EtchedPixels/Z180MiniITX/README.md

# Z180 Mini-ITX Mother Board

This very much an initial work in progress.
