EtchedPixels/Z180MiniITX/Z180Mboard-v3.kicad_pcb

## KiCad design Z180Mboard-v3.kicad_pcb (2022-03-06)

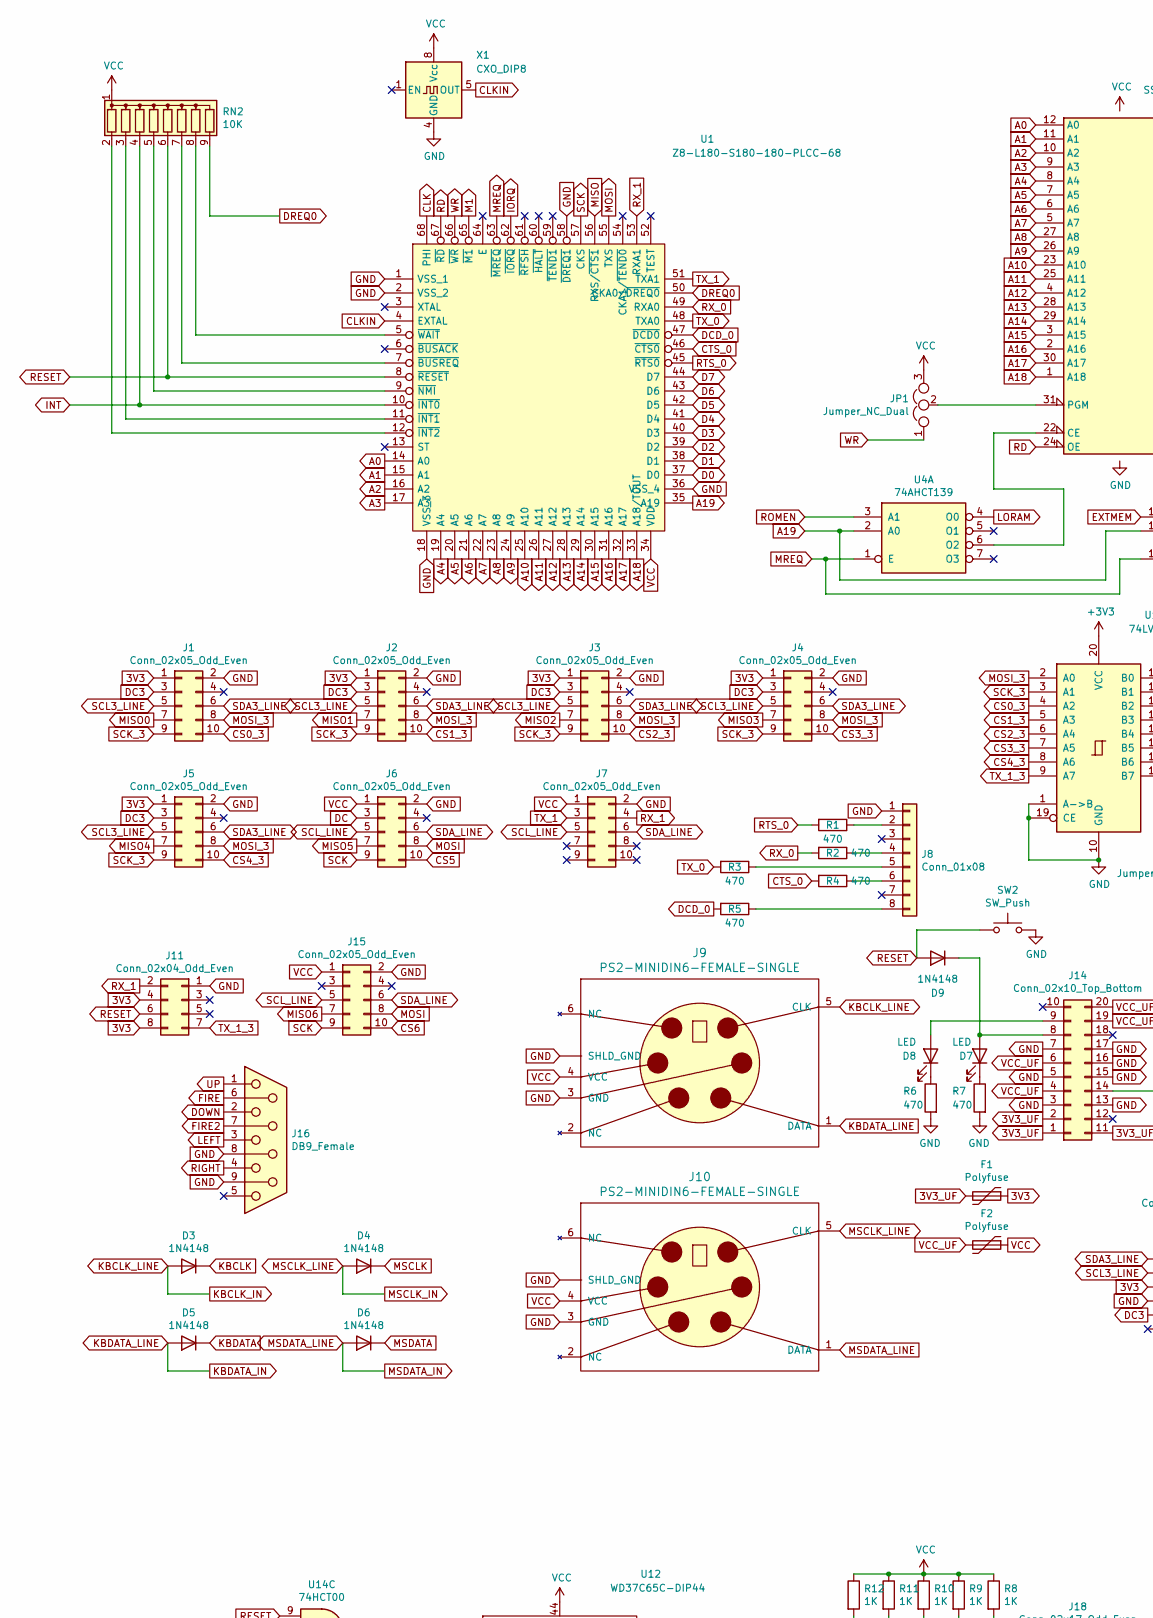
[picture p1: schematic Z180Mboard-v3.sch, part in row 1, column 1]

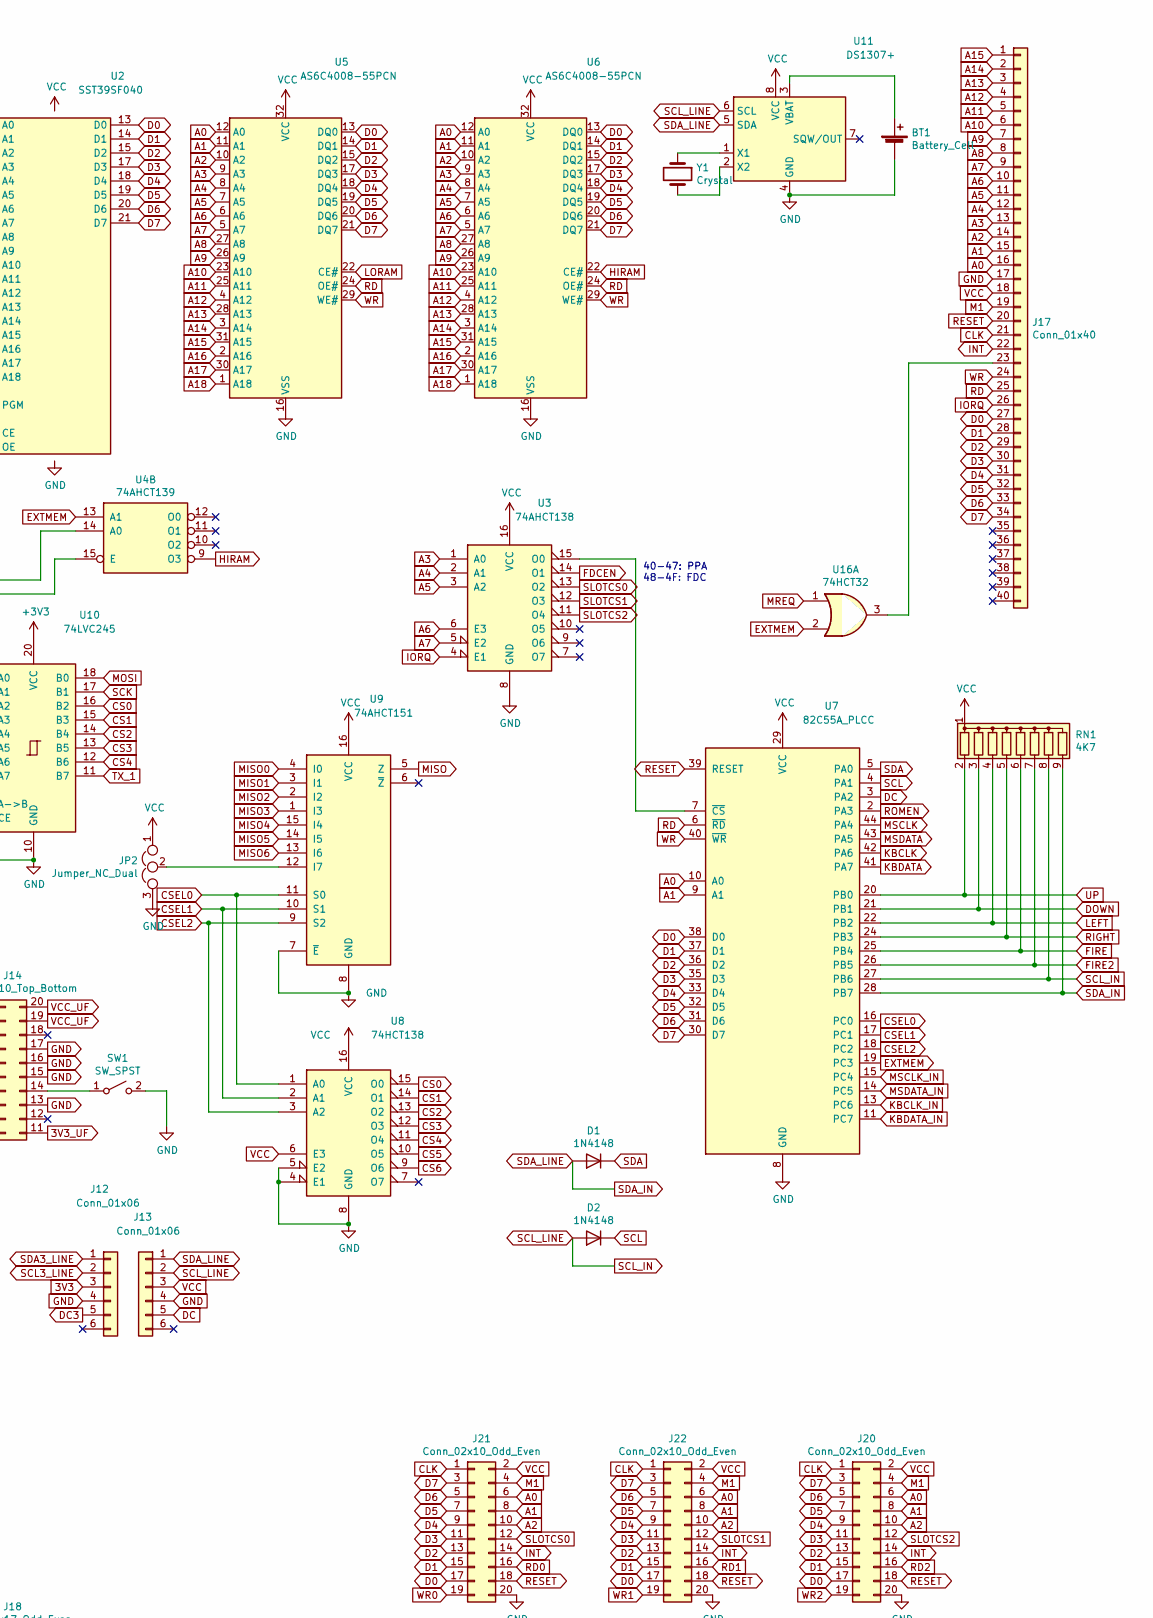
[picture p2: schematic Z180Mboard-v3.sch, part in row 1, column 2]

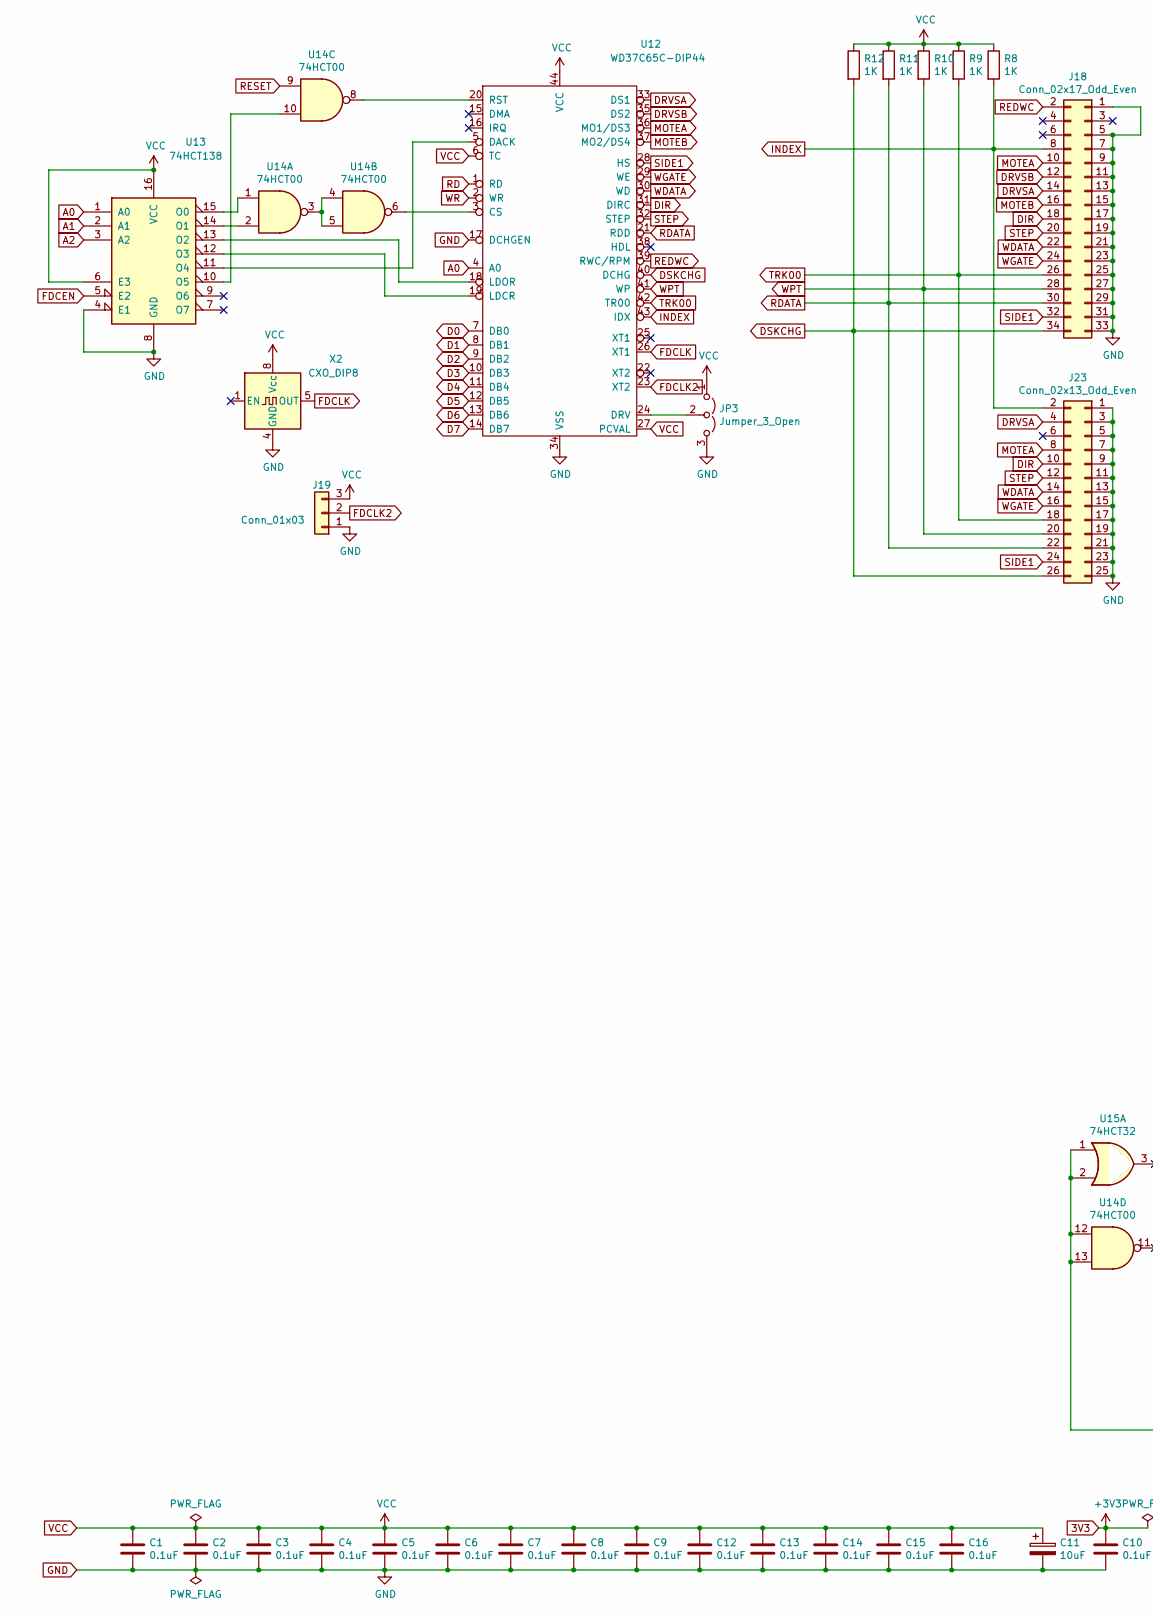
[picture p3: schematic Z180Mboard-v3.sch, part in row 2, column 1]

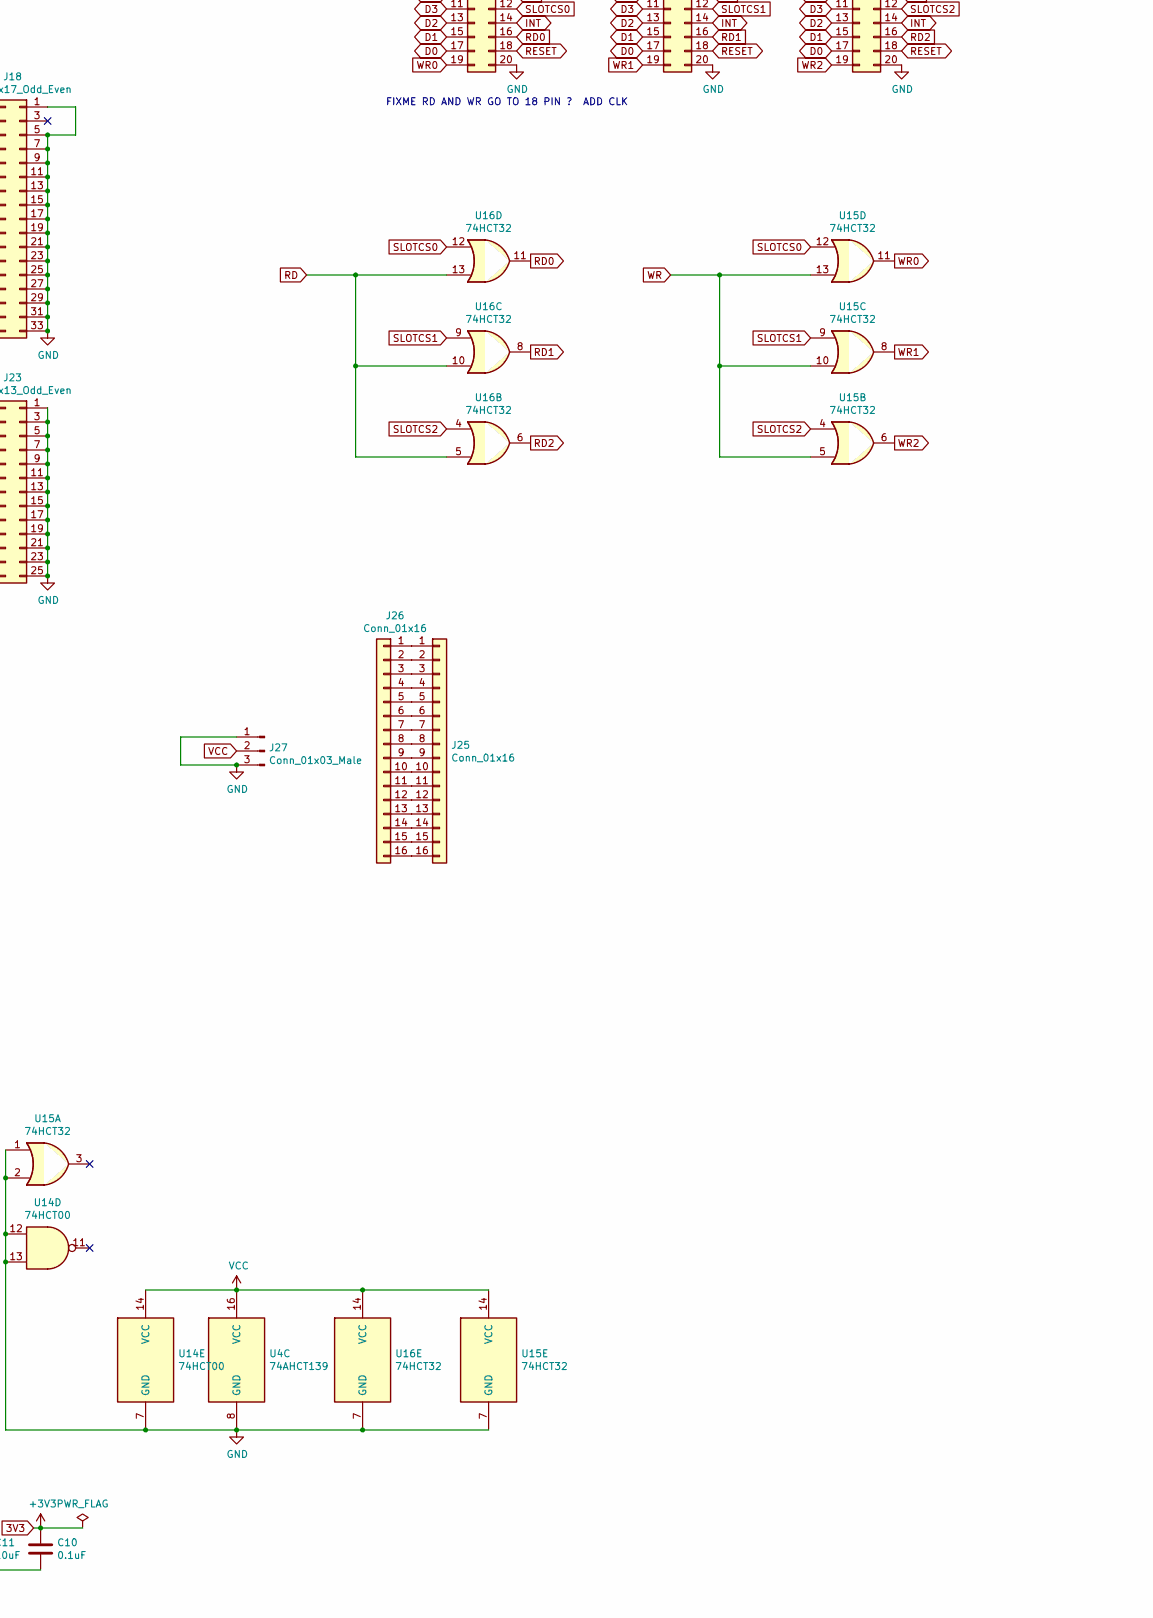
[picture p4: schematic Z180Mboard-v3.sch, part in row 2, column 2]

Parts:
BT1: Battery_Cell; BatteryHolder_Keystone_1060_1x2032
C1, C2, C3, C4, C5, C6, C7, C8, C9, C10, C12, C13, C14, C15, C16: 0.1uF; C_Disc_D3.0mm_W2.0mm_P2.50mm
C11: 10uF; CP_Radial_D10.0mm_P3.50mm
D1, D2, D3, D4, D5, D6, D9: 1N4148; D_DO-35_SOD27_P7.62mm_Horizontal
D7, D8: LED; PinHeader_1x02_P2.54mm_Vertical
F1, F2: Polyfuse; Fuse_Littelfuse-LVR100
J1, J2, J3, J4, J5, J6, J7, J15: Conn_02x05_Odd_Even; IDC-Header_2x05_P2.54mm_Vertical
J8: Conn_01x08; PinSocket_1x08_P2.54mm_Horizontal
J9, J10: PS2-MINIDIN6-FEMALE-SINGLE; MINI-DIN-6-FULL-SHIELD
J11: Conn_02x04_Odd_Even; PinSocket_2x04_P2.54mm_Vertical
J12, J13: Conn_01x06; PinHeader_1x06_P2.54mm_Vertical
J14: Conn_02x10_Top_Bottom; Molex_Mini-Fit_Jr_5566-20A_2x10_P4.20mm_Vertical
J16: DB9_Female; DSUB-9_Female_Horizontal_P2.77x2.54mm_EdgePinOffset9.40mm
J17: Conn_01x40; PinSocket_1x40_P2.54mm_Vertical
J18: Conn_02x17_Odd_Even; IDC-Header_2x17_P2.54mm_Vertical
J19: Conn_01x03; PinHeader_1x03_P2.54mm_Vertical
J20, J21, J22: Conn_02x10_Odd_Even; PinSocket_2x10_P2.54mm_Vertical
J23: Conn_02x13_Odd_Even; IDC-Header_2x13_P2.54mm_Vertical
J25: Conn_01x16; PinHeader_1x16_P2.54mm_Horizontal
J26: Conn_01x16; PinHeader_1x16_P2.54mm_Vertical
J27: Conn_01x03_Male; PinHeader_1x03_P2.54mm_Vertical
JP1, JP2: Jumper_NC_Dual; PinHeader_1x03_P2.54mm_Vertical
JP3: Jumper_3_Open; PinHeader_1x03_P2.54mm_Vertical
R1, R2, R3, R4, R5, R6, R7: 470; R_Axial_DIN0207_L6.3mm_D2.5mm_P7.62mm_Horizontal
R8, R9, R10, R11, R12: 1K; R_Axial_DIN0207_L6.3mm_D2.5mm_P7.62mm_Horizontal
RN1: 4K7; R_Array_SIP9
RN2: 10K; R_Array_SIP9
SW1: SW_SPST; PinHeader_1x02_P2.54mm_Vertical
SW2: SW_Push; PinHeader_1x02_P2.54mm_Vertical
U1: Z8-L180-S180-180-PLCC-68; PLCC-68_THT-Socket; Manufacturer_Part_Number Z8S18033VSG; Mouser Part Number 692-Z8S18033VSG
U2: SST39SF040; DIP-32_W15.24mm_Socket
U3: 74AHCT138; DIP-16_W7.62mm_Socket
U4: 74AHCT139; DIP-16_W7.62mm_Socket
U5, U6: AS6C4008-55PCN; DIP-32_W15.24mm
U7: 82C55A_PLCC; PLCC-44_THT-Socket
U8, U13: 74HCT138; DIP-16_W7.62mm_Socket
U9: 74AHCT151; DIP-16_W7.62mm_Socket
U10: 74LVC245; DIP-20_W7.62mm_Socket
U11: DS1307+; DIP-8_W7.62mm
U12: WD37C65C-DIP44; PLCC-44_THT-Socket
U14: 74HCT00; DIP-14_W7.62mm_Socket
U15, U16: 74HCT32; DIP-14_W7.62mm_Socket
X1, X2: CXO_DIP8; Oscillator_DIP-8
Y1: Crystal; Crystal_C26-LF_D2.1mm_L6.5mm_Vertical

Connections:
3V3: C10.1, F1.1, J1.1, J2.1, J3.1, J4.1, J5.1, J11.4, J11.8, J12.3, U10.20 (VCC)
3V3_UF: F1.2, J14.1, J14.2, J14.11
A0: J17.16, J20.6, J21.6, J22.6, U1.14 (A0), U2.12 (A0), U5.12 (A0), U6.12 (A0), U7.10 (A0), U12.4 (A0), U13.1 (A0)
A1: J17.15, J20.8, J21.8, J22.8, U1.15 (A1), U2.11 (A1), U5.11 (A1), U6.11 (A1), U7.9 (A1), U13.2 (A1)
A2: J17.14, J20.10, J21.10, J22.10, U1.16 (A2), U2.10 (A2), U5.10 (A2), U6.10 (A2), U13.3 (A2)
A3: J17.13, U1.17 (A3), U2.9 (A3), U3.1 (A0), U5.9 (A3), U6.9 (A3)
A4: J17.12, U1.19 (A4), U2.8 (A4), U3.2 (A1), U5.8 (A4), U6.8 (A4)
A5: J17.11, U1.20 (A5), U2.7 (A5), U3.3 (A2), U5.7 (A5), U6.7 (A5)
A6: J17.10, U1.21 (A6), U2.6 (A6), U3.6 (E3), U5.6 (A6), U6.6 (A6)
A7: J17.9, U1.22 (A7), U2.5 (A7), U3.5 (E2), U5.5 (A7), U6.5 (A7)
A8: J17.8, U1.23 (A8), U2.27 (A8), U5.27 (A8), U6.27 (A8)
A9: J17.7, U1.24 (A9), U2.26 (A9), U5.26 (A9), U6.26 (A9)
A10: J17.6, U1.25 (A10), U2.23 (A10), U5.23 (A10), U6.23 (A10)
A11: J17.5, U1.26 (A11), U2.25 (A11), U5.25 (A11), U6.25 (A11)
A12: J17.4, U1.27 (A12), U2.4 (A12), U5.4 (A12), U6.4 (A12)
A13: J17.3, U1.28 (A13), U2.28 (A13), U5.28 (A13), U6.28 (A13)
A14: J17.2, U1.29 (A14), U2.29 (A14), U5.3 (A14), U6.3 (A14)
A15: J17.1, U1.30 (A15), U2.3 (A15), U5.31 (A15), U6.31 (A15)
A16: U1.31 (A16), U2.2 (A16), U5.2 (A16), U6.2 (A16)
A17: U1.32 (A17), U2.30 (A17), U5.30 (A17), U6.30 (A17)
A18: U1.33 (A18/TOUT), U2.1 (A18), U5.1 (A18), U6.1 (A18)
A19: U1.35 (A19), U4.2 (A0), U4.14 (A0)
CLK: J17.21, J20.1, J21.1, J22.1, U1.68 (PHI)
CLKIN: U1.4 (EXTAL), X1.5 (OUT)
CS0: U8.15 (O0), U10.16 (B2)
CS0_3: J1.10, U10.4 (A2)
CS1: U8.14 (O1), U10.15 (B3)
CS1_3: J2.10, U10.5 (A3)
CS2: U8.13 (O2), U10.14 (B4)
CS2_3: J3.10, U10.6 (A4)
CS3: U8.12 (O3), U10.13 (B5)
CS3_3: J4.10, U10.7 (A5)
CS4: U8.11 (O4), U10.12 (B6)
CS4_3: J5.10, U10.8 (A6)
CS5: J6.10, U8.10 (O5)
CS6: J15.10, U8.9 (O6)
CSEL0: U7.16 (PC0), U8.1 (A0), U9.11 (S0)
CSEL1: U7.17 (PC1), U8.2 (A1), U9.10 (S1)
CSEL2: U7.18 (PC2), U8.3 (A2), U9.9 (S2)
CTS_0: R4.2, U1.46 (~CTS0)
D0: J17.27, J20.17, J21.17, J22.17, U1.37 (D0), U2.13 (D0), U5.13 (DQ0), U6.13 (DQ0), U7.38 (D0), U12.7 (DB0)
D1: J17.28, J20.15, J21.15, J22.15, U1.38 (D1), U2.14 (D1), U5.14 (DQ1), U6.14 (DQ1), U7.37 (D1), U12.8 (DB1)
D2: J17.29, J20.13, J21.13, J22.13, U1.39 (D2), U2.15 (D2), U5.15 (DQ2), U6.15 (DQ2), U7.36 (D2), U12.9 (DB2)
D3: J17.30, J20.11, J21.11, J22.11, U1.40 (D3), U2.17 (D3), U5.17 (DQ3), U6.17 (DQ3), U7.35 (D3), U12.10 (DB3)
D4: J17.31, J20.9, J21.9, J22.9, U1.41 (D4), U2.18 (D4), U5.18 (DQ4), U6.18 (DQ4), U7.33 (D4), U12.11 (DB4)
D5: J17.32, J20.7, J21.7, J22.7, U1.42 (D5), U2.19 (D5), U5.19 (DQ5), U6.19 (DQ5), U7.32 (D5), U12.12 (DB5)
D6: J17.33, J20.5, J21.5, J22.5, U1.43 (D6), U2.20 (D6), U5.20 (DQ6), U6.20 (DQ6), U7.31 (D6), U12.13 (DB6)
D7: J17.34, J20.3, J21.3, J22.3, U1.44 (D7), U2.21 (D7), U5.21 (DQ7), U6.21 (DQ7), U7.30 (D7), U12.14 (DB7)
DC: J6.3, J13.5, U7.3 (PA2)
DC3: J1.3, J2.3, J3.3, J4.3, J5.3, J12.5
DCD_0: R5.2, U1.47 (~DCD0)
DIR: J18.18, J23.10, U12.31 (DIRC)
DOWN: J16.2, RN1.3 (R2), U7.21 (PB1)
DREQ0: RN2.9 (R8), U1.50 (CKA0/~DREQ0)
DRVSA: J18.14, J23.4, U12.33 (DS1)
DRVSB: J18.12, U12.35 (DS2)
DSKCHG: J18.34, J23.26, R12.2, U12.40 (DCHG)
EXTMEM: U4.13 (A1), U7.19 (PC3), U16.2
FDCEN: U3.14 (O1), U13.5 (E2)
FDCLK: U12.26 (XT1), X2.5 (OUT)
FDCLK2: J19.2, U12.23 (XT2)
FIRE: J16.6, RN1.6 (R5), U7.25 (PB4)
FIRE2: J16.7, RN1.7 (R6), U7.26 (PB5)
GND: BT1.2 (-), C1.2, C2.2, C3.2, C4.2, C5.2, C6.2, C7.2, C8.2, C9.2, C10.2, C11.2, C12.2, C13.2, C14.2, C15.2, C16.2, J1.2, J2.2, J3.2, J4.2, J5.2, J6.2, J7.2, J8.1, J9.3 (GND), J9.~ (SHLD_GND), J10.3 (GND), J10.~ (SHLD_GND), J11.1, J12.4, J13.4, J14.3, J14.5, J14.7, J14.13, J14.15, J14.16, J14.17, J15.2, J16.8, J16.9, J17.17, J18.1, J18.5, J18.7, J18.9, J18.11, J18.13, J18.15, J18.17, J18.19, J18.21, J18.23, J18.25, J18.27, J18.29, J18.31, J18.33, J19.1, J20.20, J21.20, J22.20, J23.1, J23.3, J23.5, J23.7, J23.9, J23.11, J23.13, J23.15, J23.17, J23.19, J23.21, J23.23, J23.25, J27.1, J27.3, JP2.3, JP3.3 (B), R6.2, R7.2, SW1.2 (B), SW2.2, U1.1 (VSS_1), U1.2 (VSS_2), U1.18 (VSS_3), U1.36 (VSS_4), U1.58 (~DREQ1), U2.16 (GND), U3.8 (GND), U4.8 (GND), U5.16 (VSS), U6.16 (VSS), U7.8 (GND), U8.4 (E1), U8.5 (E2), U8.8 (GND), U9.7 (~E), U9.8 (GND), U10.1 (A->B), U10.10 (GND), U10.19 (CE), U11.4 (GND), U12.17 (DCHGEN), U12.34 (VSS), U13.4 (E1), U13.8 (GND), U14.7 (GND), U14.12, U14.13, U15.1, U15.2, U15.7 (GND), U16.7 (GND), X1.4 (GND), X2.4 (GND)
HIRAM: U4.9 (O3), U6.22 (CE#)
INDEX: J18.8, J23.2, R8.2, U12.43 (IDX)
INT: J17.22, J20.14, J21.14, J22.14, RN2.4 (R3), U1.10 (~INT0)
IORQ: J17.26, U1.62 (~IORQ), U3.4 (E1)
KBCLK: D3.1 (K), U7.42 (PA6)
KBCLK_IN: D3.2 (A), J9.5 (CLK), U7.13 (PC6)
KBDATA: D5.1 (K), U7.41 (PA7)
KBDATA_IN: D5.2 (A), J9.1 (DATA), U7.11 (PC7)
LEFT: J16.3, RN1.4 (R3), U7.22 (PB2)
LORAM: U4.4 (O0), U5.22 (CE#)
M1: J17.19, J20.4, J21.4, J22.4, U1.65 (~M1)
MISO: U1.56 (RXS/~CTS1), U9.5 (Z)
MISO0: J1.7, U9.4 (I0)
MISO1: J2.7, U9.3 (I1)
MISO2: J3.7, U9.2 (I2)
MISO3: J4.7, U9.1 (I3)
MISO4: J5.7, U9.15 (I4)
MISO5: J6.7, U9.14 (I5)
MISO6: J15.7, U9.13 (I6)
MOSI: J6.8, J15.8, U1.55 (TXS), U10.18 (B0)
MOSI_3: J1.8, J2.8, J3.8, J4.8, J5.8, U10.2 (A0)
MOTEA: J18.10, J23.8, U12.36 (MO1/DS3)
MOTEB: J18.16, U12.37 (MO2/DS4)
MREQ: U1.63 (~MREQ), U4.1 (E), U4.15 (E), U16.1
MSCLK: D4.1 (K), U7.44 (PA4)
MSCLK_IN: D4.2 (A), J10.5 (CLK), U7.15 (PC4)
MSDATA: D6.1 (K), U7.43 (PA5)
MSDATA_IN: D6.2 (A), J10.1 (DATA), U7.14 (PC5)
unnamed: BT1.1 (+), U11.3 (VBAT)
unnamed: D7.1 (K), R7.1
unnamed: D7.2 (A), D9.1 (K), J14.8
unnamed: D8.1 (K), R6.1
unnamed: D8.2 (A), J14.9
unnamed: J8.2, R1.1
unnamed: J8.4, R2.1
unnamed: J8.5, R3.1
unnamed: J8.6, R4.1
unnamed: J8.8, R5.1
unnamed: J14.14, SW1.1 (A)
unnamed: J17.23, U16.3
unnamed: J25.1, J26.1
unnamed: J25.2, J26.2
unnamed: J25.3, J26.3
unnamed: J25.4, J26.4
unnamed: J25.5, J26.5
unnamed: J25.6, J26.6
unnamed: J25.7, J26.7
unnamed: J25.8, J26.8
unnamed: J25.9, J26.9
unnamed: J25.10, J26.10
unnamed: J25.11, J26.11
unnamed: J25.12, J26.12
unnamed: J25.13, J26.13
unnamed: J25.14, J26.14
unnamed: J25.15, J26.15
unnamed: J25.16, J26.16
unnamed: JP1.2, U2.31 (PGM)
unnamed: JP2.2, U9.12 (I7)
unnamed: JP3.2 (C), U12.24 (DRV)
unnamed: RN2.2 (R1), U1.12 (~INT2)
unnamed: RN2.3 (R2), U1.11 (~INT1)
unnamed: RN2.5 (R4), U1.9 (~NMI)
unnamed: RN2.7 (R6), U1.7 (~BUSREQ)
unnamed: RN2.8 (R7), U1.5 (~WAIT)
unnamed: U2.22 (CE), U4.6 (O2)
unnamed: U3.15 (O0), U7.7 (~CS~)
unnamed: U11.1 (X1), Y1.1
unnamed: U11.2 (X2), Y1.2
unnamed: U12.3 (CS), U14.6
unnamed: U12.5 (DACK), U13.11 (O4)
unnamed: U12.18 (LDOR), U13.13 (O2)
unnamed: U12.19 (LDCR), U13.12 (O3)
unnamed: U12.20 (RST), U14.8
unnamed: U13.10 (O5), U14.10
unnamed: U13.14 (O1), U14.2
unnamed: U13.15 (O0), U14.1
unnamed: U14.3, U14.4, U14.5
RD: J17.25, U1.67 (~RD), U2.24 (OE), U5.24 (OE#), U6.24 (OE#), U7.6 (~RD~), U12.1 (RD), U16.5, U16.10, U16.13
RD0: J21.16, U16.11
RD1: J22.16, U16.8
RD2: J20.16, U16.6
RDATA: J18.30, J23.22, R11.2, U12.21 (RDD)
REDWC: J18.2, U12.39 (RWC/RPM)
RESET: D9.2 (A), J11.6, J17.20, J20.18, J21.18, J22.18, RN2.6 (R5), SW2.1, U1.8 (~RESET), U7.39 (RESET), U14.9
RIGHT: J16.4, RN1.5 (R4), U7.24 (PB3)
ROMEN: U4.3 (A1), U7.2 (PA3)
RTS_0: R1.2, U1.45 (~RTS0)
RX_0: R2.2, U1.49 (RXA0)
RX_1: J7.4, J11.2, U1.53 (RXA1)
SCK: J6.9, J15.9, U1.57 (CKS), U10.17 (B1)
SCK_3: J1.9, J2.9, J3.9, J4.9, J5.9, U10.3 (A1)
SCL: D2.1 (K), U7.4 (PA1)
SCL3_LINE: J1.5, J2.5, J3.5, J4.5, J5.5, J12.2
SCL_IN: D2.2 (A), J6.5, J7.5, J13.2, J15.5, RN1.8 (R7), U7.27 (PB6), U11.6 (SCL)
SDA: D1.1 (K), U7.5 (PA0)
SDA3_LINE: J1.6, J2.6, J3.6, J4.6, J5.6, J12.1
SDA_IN: D1.2 (A), J6.6, J7.6, J13.1, J15.6, RN1.9 (R8), U7.28 (PB7), U11.5 (SDA)
SIDE1: J18.32, J23.24, U12.28 (HS)
SLOTCS0: J21.12, U3.13 (O2), U15.12, U16.12
SLOTCS1: J22.12, U3.12 (O3), U15.9, U16.9
SLOTCS2: J20.12, U3.11 (O4), U15.4, U16.4
STEP: J18.20, J23.12, U12.32 (STEP)
TRK00: J18.26, J23.18, R9.2, U12.42 (TR00)
TX_0: R3.2, U1.48 (TXA0)
TX_1: J7.3, U1.51 (TXA1), U10.11 (B7)
TX_1_3: J11.7, U10.9 (A7)
UP: J16.1, RN1.2 (R1), U7.20 (PB0)
VCC: C1.1, C2.1, C3.1, C4.1, C5.1, C6.1, C7.1, C8.1, C9.1, C11.1, C12.1, C13.1, C14.1, C15.1, C16.1, F2.1, J6.1, J7.1, J9.4 (VCC), J10.4 (VCC), J13.3, J15.1, J17.18, J19.3, J20.2, J21.2, J22.2, J27.2, JP1.3, JP2.1, JP3.1 (A), R8.1, R9.1, R10.1, R11.1, R12.1, RN1.1 (common), RN2.1 (common), U1.34 (VDD), U2.32 (VCC), U3.16 (VCC), U4.16 (VCC), U5.32 (VCC), U6.32 (VCC), U7.29 (VCC), U8.6 (E3), U8.16 (VCC), U9.16 (VCC), U11.8 (VCC), U12.6 (TC), U12.27 (PCVAL), U12.44 (VCC), U13.6 (E3), U13.16 (VCC), U14.14 (VCC), U15.14 (VCC), U16.14 (VCC), X1.8 (Vcc), X2.8 (Vcc)
VCC_UF: F2.2, J14.4, J14.6, J14.19, J14.20
WDATA: J18.22, J23.14, U12.30 (WD)
WGATE: J18.24, J23.16, U12.29 (WE)
WPT: J18.28, J23.20, R10.2, U12.41 (WP)
WR: J17.24, JP1.1, U1.66 (~WR), U5.29 (WE#), U6.29 (WE#), U7.40 (~WR~), U12.2 (WR), U15.5, U15.10, U15.13
WR0: J21.19, U15.11
WR1: J22.19, U15.8
WR2: J20.19, U15.6

Notes on the sheet:
40-47: PPA 48-4F: FDC
FIXME RD AND WR GO TO 18 PIN ? ADD CLK

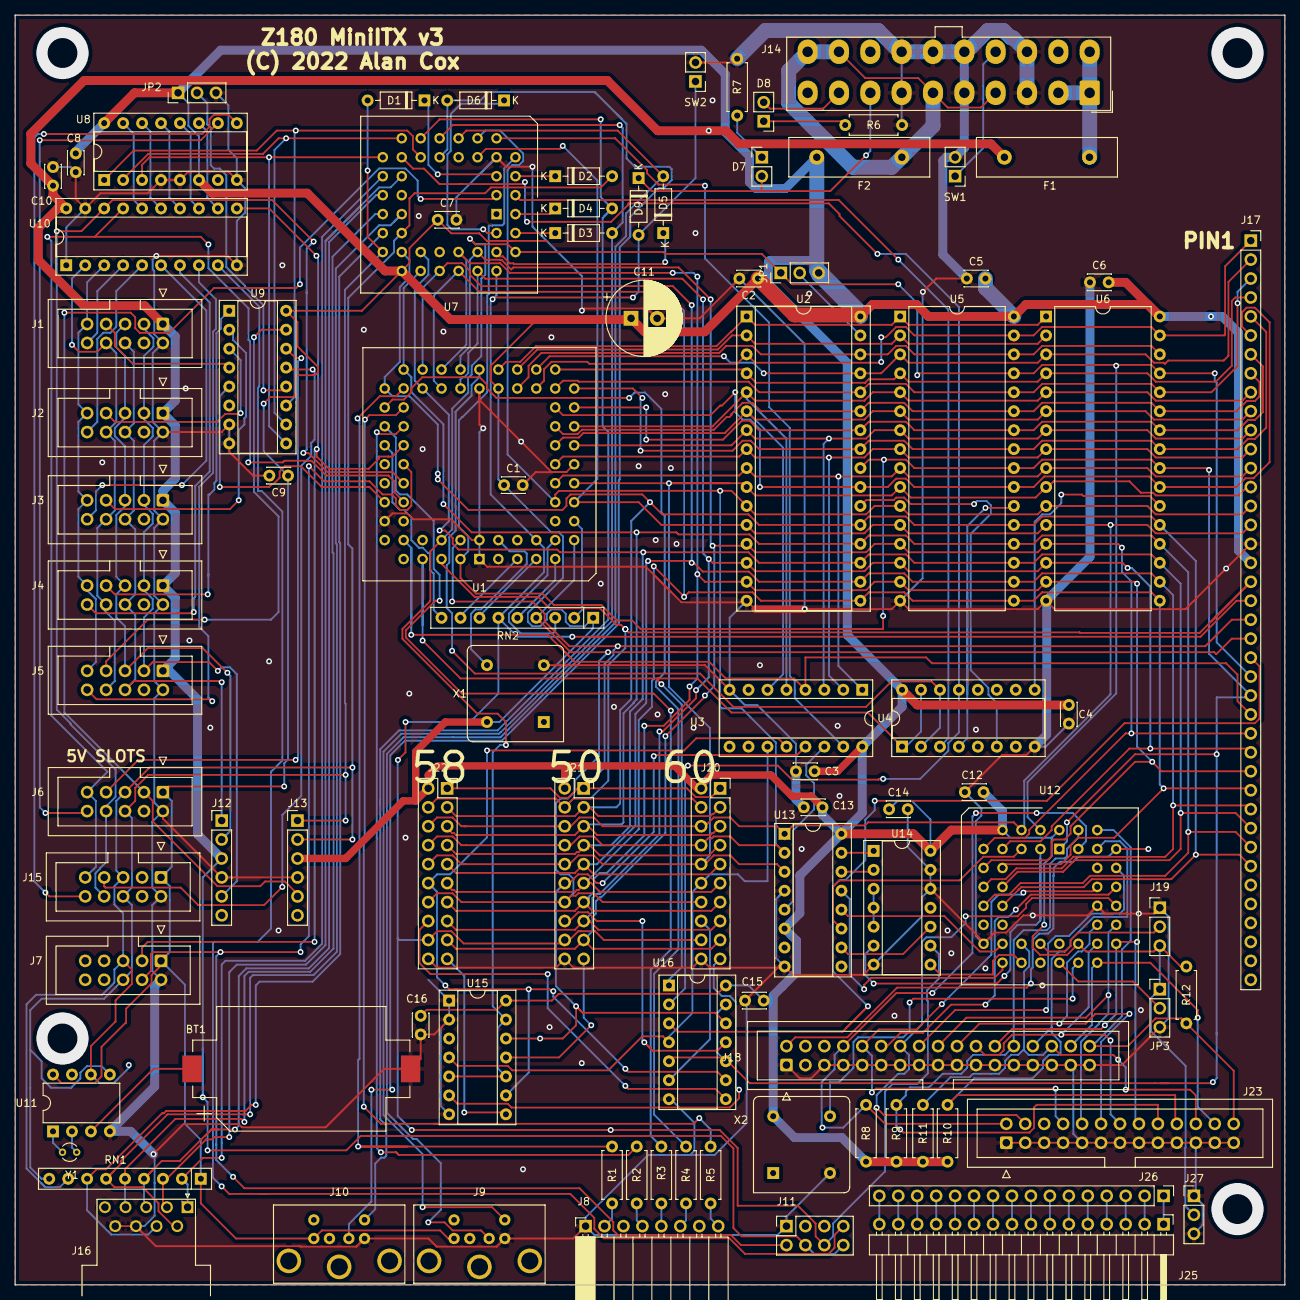
[picture p5: board Z180Mboard-v3.kicad_pcb from above]

Board: 2 copper layers, 170.2 x 170.2 mm, 92 parts (0 on the bottom side), 180 nets.
