EtchedPixels/Z180MiniITX/(threads)

Thread 1 (2021-08-12):

ATX12VO branch

erkinalp, 2021-08-12:

erkinalp, 2021-08-17:
ATX12VO is a new power standard from Intel, which only provides 12V power input to the motherboard, and removes 5V and 3V3 power inputs, also shrinking the motherboard power connector to 10 pins from the previous 24. This simplifies the power supply designs, reduces wire losses and makes them more efficient. Given Z180's power consumption, a two-phase switching regulator design would be more than enough.

Closed 2021-08-13.

Thread 3 (2021-08-19):

Pico-BTX variant

erkinalp, 2021-08-19:
There are a lot of BTX cases out there, such as HP EliteDesk. MiniITX boards are incompatible with them. Hence, a branch with a Pico-BTX variant could be useful.

Closed 2021-08-19.
