EtchedPixels/Z180MiniITX/(commit log)

2021-08-12 z180mboard: Add the floppy disk interface
    [Z180Mboard.kicad_pcb, Z180Mboard.sch]
2021-08-12 z180mboard: pack things in more tightly, turn the battery vertical
    [Z180Mboard.kicad_pcb, Z180Mboard.sch]
2021-08-13 z180mboard; Add video, holes tidy stuff up
    [Z180Mboard.kicad_pcb, Z180Mboard.sch]
2021-08-14 Z180Mboard: more cleaning up and connector add
    [Z180Mboard.kicad_pcb, Z180Mboard.sch]
2022-03-03 Notes for bugs/mods for v2/v3
    [Z180Mboard.kicad_pcb, Z180Mboard.sch]
2022-03-03 v3: revised board
    - Remove the experimental teletext video
    - Add 3 mini-bus slots instead
    - Relocate FDC to match external card addresses
    - Swap DC and EXTMEM over to fix 82C55 reset glitch problems
    - Remove 5v DC pin from the 3v3 slot
    - Change battery holder
    Note: the mounting holes got accidentally removed. This needs fixing before
    actually sending boards off
    [Z180Mboard-v3.csv, Z180Mboard-v3.kicad_pcb, Z180Mboard-v3.sch]
2022-03-06 v3: Hopefully the final revision for this attempt
    [Z180Mboard-v3.kicad_pcb, Z180Mboard-v3.sch]
