EtchedPixels/Z180MiniITX/(notices)

Notices in the files:
Z180Mboard-v3.kicad_pcb:
(C) 2022 Alan Cox
